OpenSourceNeuro/PoorLabs-Stimulator-V2/3D Renderings/Left.dxf

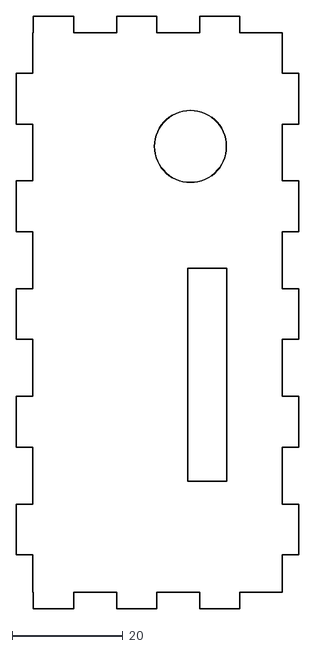
[picture p11: CAD file, 2023-07-23]
3D Renderings/Left.dxf
51.0 x 107.0
