OpenSourceNeuro/PoorLabs-Stimulator-V2/3D Renderings/Front.dxf

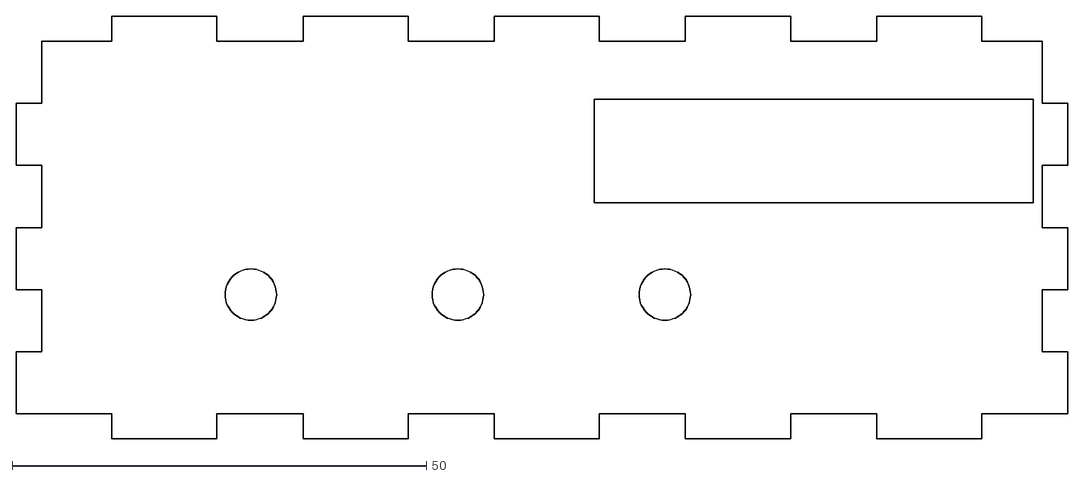
[picture p12: CAD file, 2023-07-23]
3D Renderings/Front.dxf
127.0 x 51.0
