OpenSourceNeuro/PoorLabs-Stimulator-V2/3D Renderings/Top.dxf

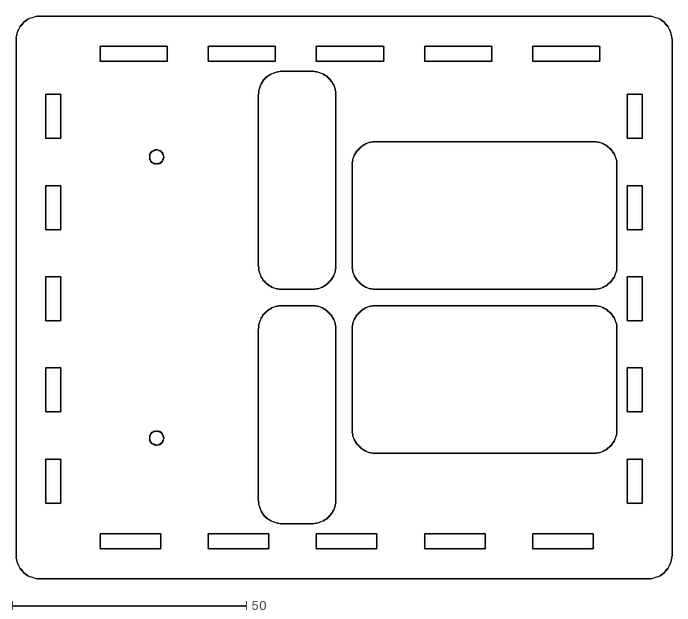
[picture p13: CAD file, 2023-07-23]
3D Renderings/Top.dxf
140.0 x 120.0
