OpenSourceNeuro/PoorLabs-Stimulator-V2/3D Renderings/Back.dxf

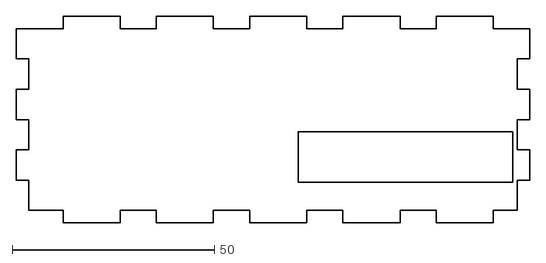
[picture p14: CAD file, 2023-07-23]
3D Renderings/Back.dxf
127.0 x 51.0
