OpenSourceNeuro/PoorLabs-Stimulator-V2/3D Renderings/Right.dxf

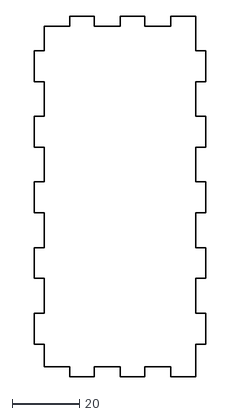
[picture p15: CAD file, 2023-07-23]
3D Renderings/Right.dxf
51.0 x 107.0
