OpenSourceNeuro/PoorLabs-Stimulator-V2/3D Renderings/Bottom.dxf

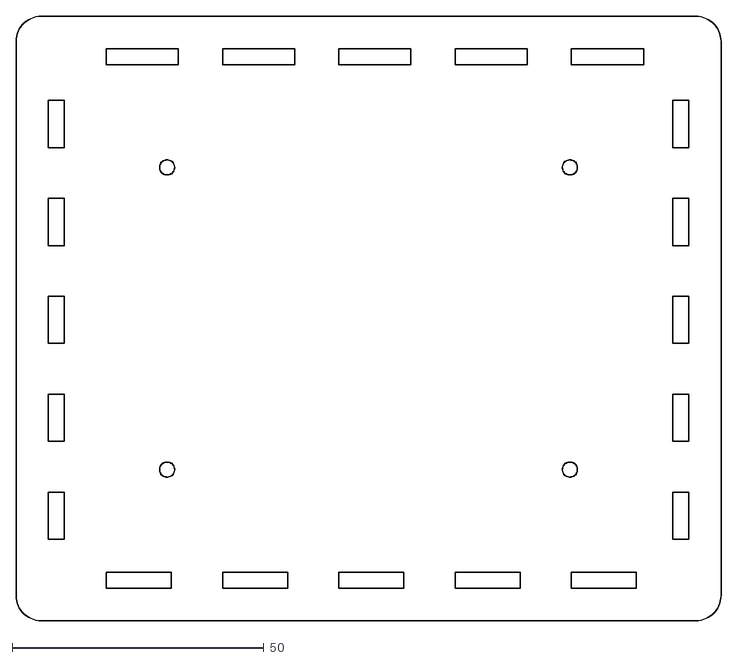
[picture p16: CAD file, 2023-07-23]
3D Renderings/Bottom.dxf
140.0 x 120.0
