OpenSourceNeuro/PoorLabs-Stimulator-V2/Documentation/Thorlabs Chrolis - Breakout Box/BBC1-AutoCADDXF.dxf

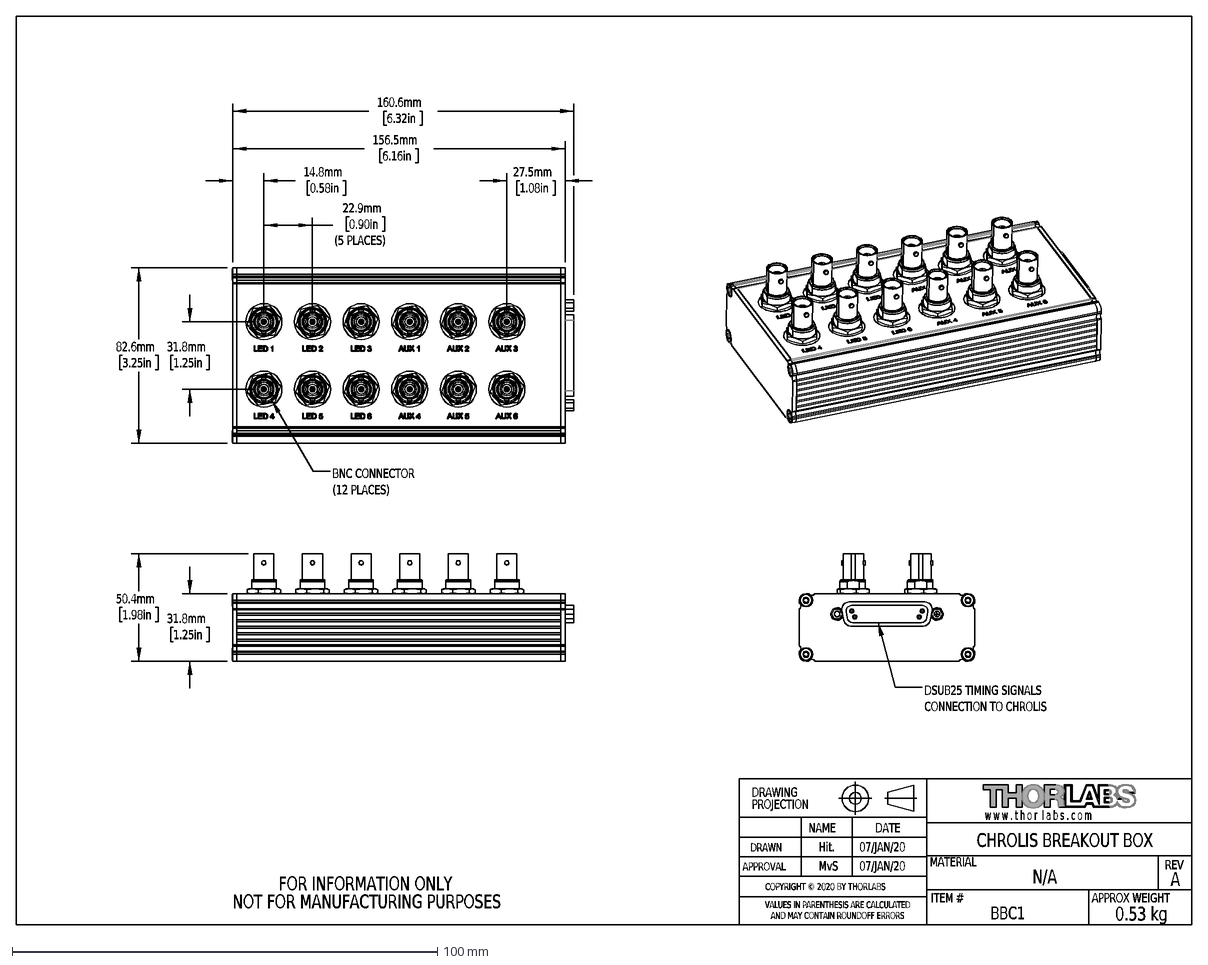
[picture p17: CAD file, 2023-07-23]
Documentation/Thorlabs Chrolis - Breakout Box/BBC1-AutoCADDXF.dxf
A
BBC1
MATERIAL
DRAWN
APPROVAL
REV
Hit.
MvS
07/JAN/20
DATE
w w w . t h o r l a b s . c o m
ITEM #
APPROX WEIGHT
N/A
0.53 kg
VALUES IN PARENTHESIS ARE CALCULATED
AND MAY CONTAIN ROUNDOFF ERRORS
DRAWING
PROJECTION
NAME
FOR INFORMATION ONLY
NOT FOR MANUFACTURING PURPOSES
CHROLIS BREAKOUT BOX
COPYRIGHT © 2020 BY THORLABS
160.6mm
6.32in
156.5mm
6.16in
14.8mm
0.58in
22.9mm
0.90in
(5 PLACES)
31.8mm
1.25in
82.6mm
3.25in
27.5mm
1.08in
BNC CONNECTOR
(12 PLACES)
50.4mm
1.98in
DSUB25 TIMING SIGNALS
CONNECTION TO CHROLIS
