OpenSourceNeuro/PoorLabs-Stimulator-V2/Documentation/Thorlabs Chrolis - Breakout Box/BBC1-Solidworks.sldprt

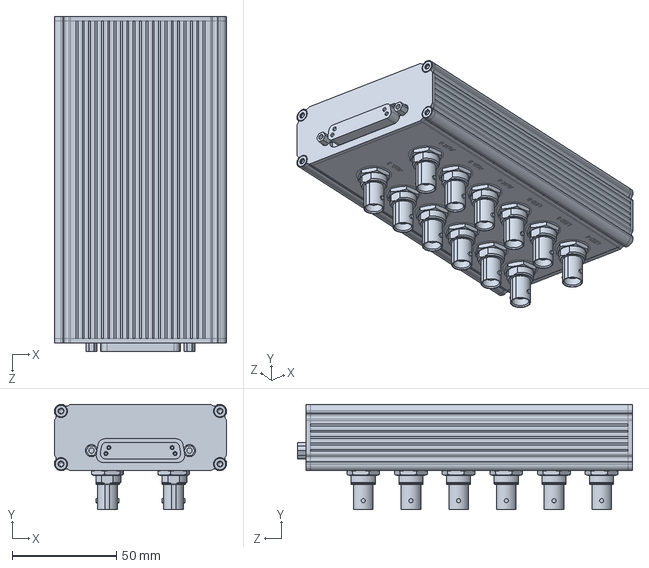
[picture p18: CAD file, 2023-07-23]
Documentation/Thorlabs Chrolis - Breakout Box/BBC1-Solidworks.sldprt
82.5 x 50.4 x 160.6 mm
