OpenSourceNeuro/PoorLabs-Stimulator-V2/Documentation/Thorlabs Chrolis - Breakout Box/BBC1-AutoCADPDF.pdf

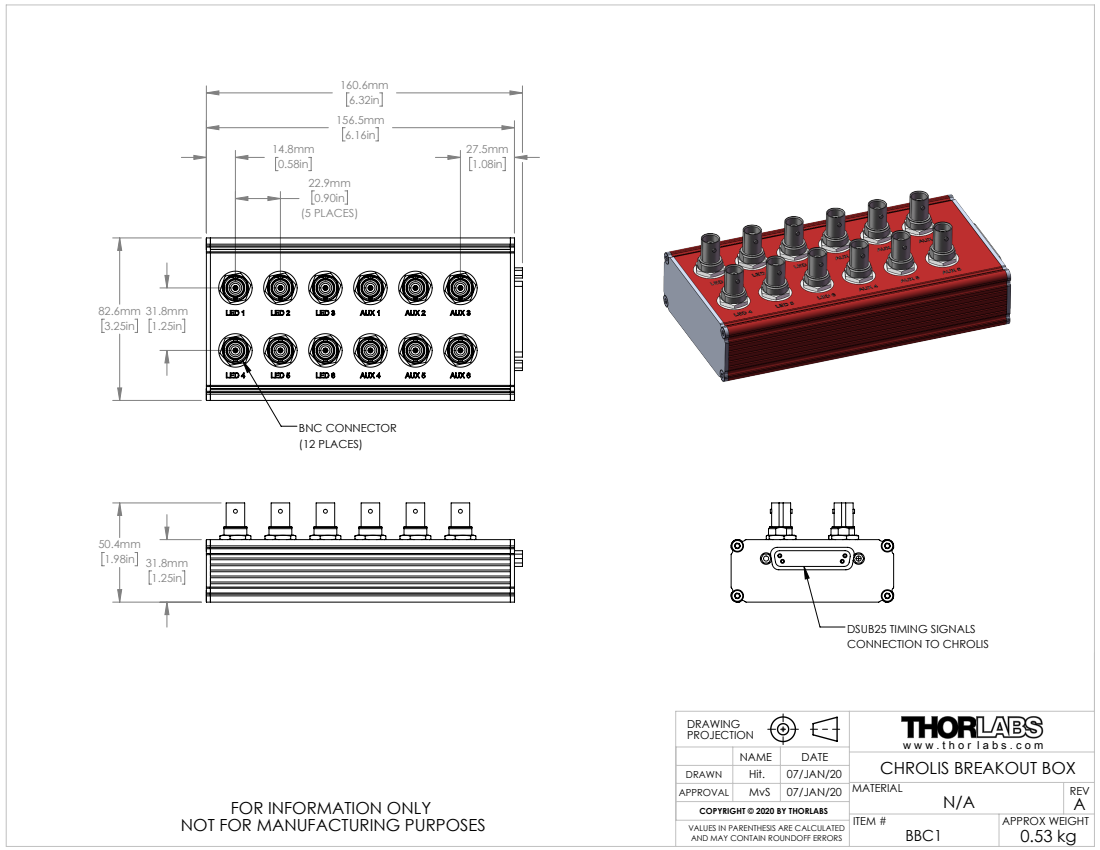
[picture p19: page 1]
(5 PLACES); BNC CONNECTOR (12 PLACES); ITEM #; APPROX WEIGHT

DSUB25 TIMING SIGNALS
CONNECTION TO CHROLIS

DRAWING PROJECTION | | w w w . t h o r l a b s . c o m

NAME | DATE
APPROVAL | MvS | 07/JAN/20 | MATERIAL N/A | REV A

CHROLIS BREAKOUT BOX

DRAWN | Hit. | 07/JAN/20

FOR INFORMATION ONLY
NOT FOR MANUFACTURING PURPOSES

COPYRIGHT © 2020 BY THORLABS
0.53 kg VALUES IN PARENTHESIS ARE CALCULATED
AND MAY CONTAIN ROUNDOFF ERRORS
