OpenSourceNeuro/PoorLabs-Stimulator-V2/PCB/Chrolis-LCR-Connector/Chrolis-LCR-Connector.kicad_pcb

## KiCad design PCB/Chrolis-LCR-Connector/Chrolis-LCR-Connector.kicad_pcb (2023-07-23)

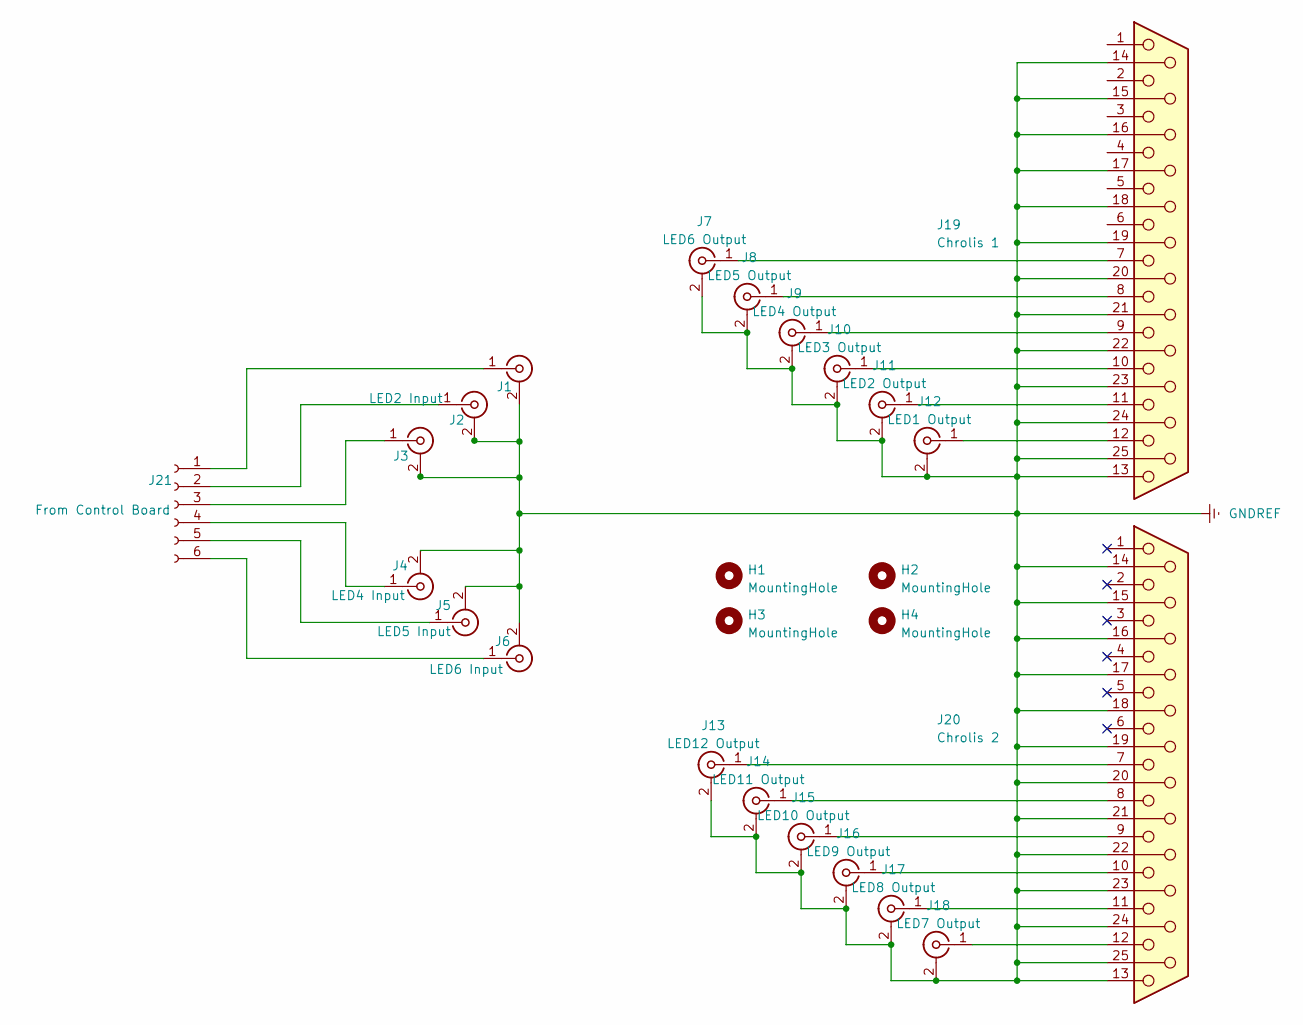
[picture p20: schematic Chrolis-LCR-Connector.kicad_sch]

Parts:
H1, H2, H3, H4: MountingHole; MountingHole_3mm
J1, J3: (no value)
J2: LED2 Input; SMA_Amphenol_132291_Vertical
J4: LED4 Input; SMA_Amphenol_132291_Vertical
J5: LED5 Input; SMA_Amphenol_132291_Vertical
J6: LED6 Input; SMA_Amphenol_132291_Vertical
J7: LED6 Output; SMA_Amphenol_132291_Vertical
J8: LED5 Output; SMA_Amphenol_132291_Vertical
J9: LED4 Output; SMA_Amphenol_132291_Vertical
J10: LED3 Output; SMA_Amphenol_132291_Vertical
J11: LED2 Output; SMA_Amphenol_132291_Vertical
J12: LED1 Output; SMA_Amphenol_132291_Vertical
J13: LED12 Output; SMA_Amphenol_132291_Vertical
J14: LED11 Output; SMA_Amphenol_132291_Vertical
J15: LED10 Output; SMA_Amphenol_132291_Vertical
J16: LED9 Output; SMA_Amphenol_132291_Vertical
J17: LED8 Output; SMA_Amphenol_132291_Vertical
J18: LED7 Output; SMA_Amphenol_132291_Vertical
J19: Chrolis 1; DSUB-25_Female_Horizontal_P2.77x2.84mm_EdgePinOffset9.90mm_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
J20: Chrolis 2; DSUB-25_Female_Horizontal_P2.77x2.84mm_EdgePinOffset9.90mm_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
J21: From Control Board; JST_XH_S6B-XH-A_1x06_P2.50mm_Horizontal

Connections:
GNDREF: J1.2 (Ext), J4.2 (Ext), J5.2 (Ext), J6.2 (Ext), J7.2 (Ext), J8.2 (Ext), J9.2 (Ext), J10.2 (Ext), J11.2 (Ext), J12.2 (Ext), J13.2 (Ext), J14.2 (Ext), J15.2 (Ext), J16.2 (Ext), J17.2 (Ext), J18.2 (Ext), J19.13, J19.14, J19.15, J19.16, J19.17, J19.18, J19.19, J19.20, J19.21, J19.22, J19.23, J19.24, J19.25, J20.13, J20.14, J20.15, J20.16, J20.17, J20.18, J20.19, J20.20, J20.21, J20.22, J20.23, J20.24, J20.25
unnamed: J1.1 (In), J21.1
unnamed: J2.1 (In), J21.2
unnamed: J10.1 (In), J19.10
unnamed: J11.1 (In), J19.11
unnamed: J12.1 (In), J19.12
unnamed: J13.1 (In), J20.7
unnamed: J14.1 (In), J20.8
unnamed: J15.1 (In), J20.9
unnamed: J16.1 (In), J20.10
unnamed: J17.1 (In), J20.11
unnamed: J18.1 (In), J20.12
unnamed: J7.1 (In), J19.7
unnamed: J8.1 (In), J19.8
unnamed: J9.1 (In), J19.9
unnamed: J3.1 (In), J21.3
unnamed: J4.1 (In), J21.4
unnamed: J5.1 (In), J21.5
unnamed: J6.1 (In), J21.6

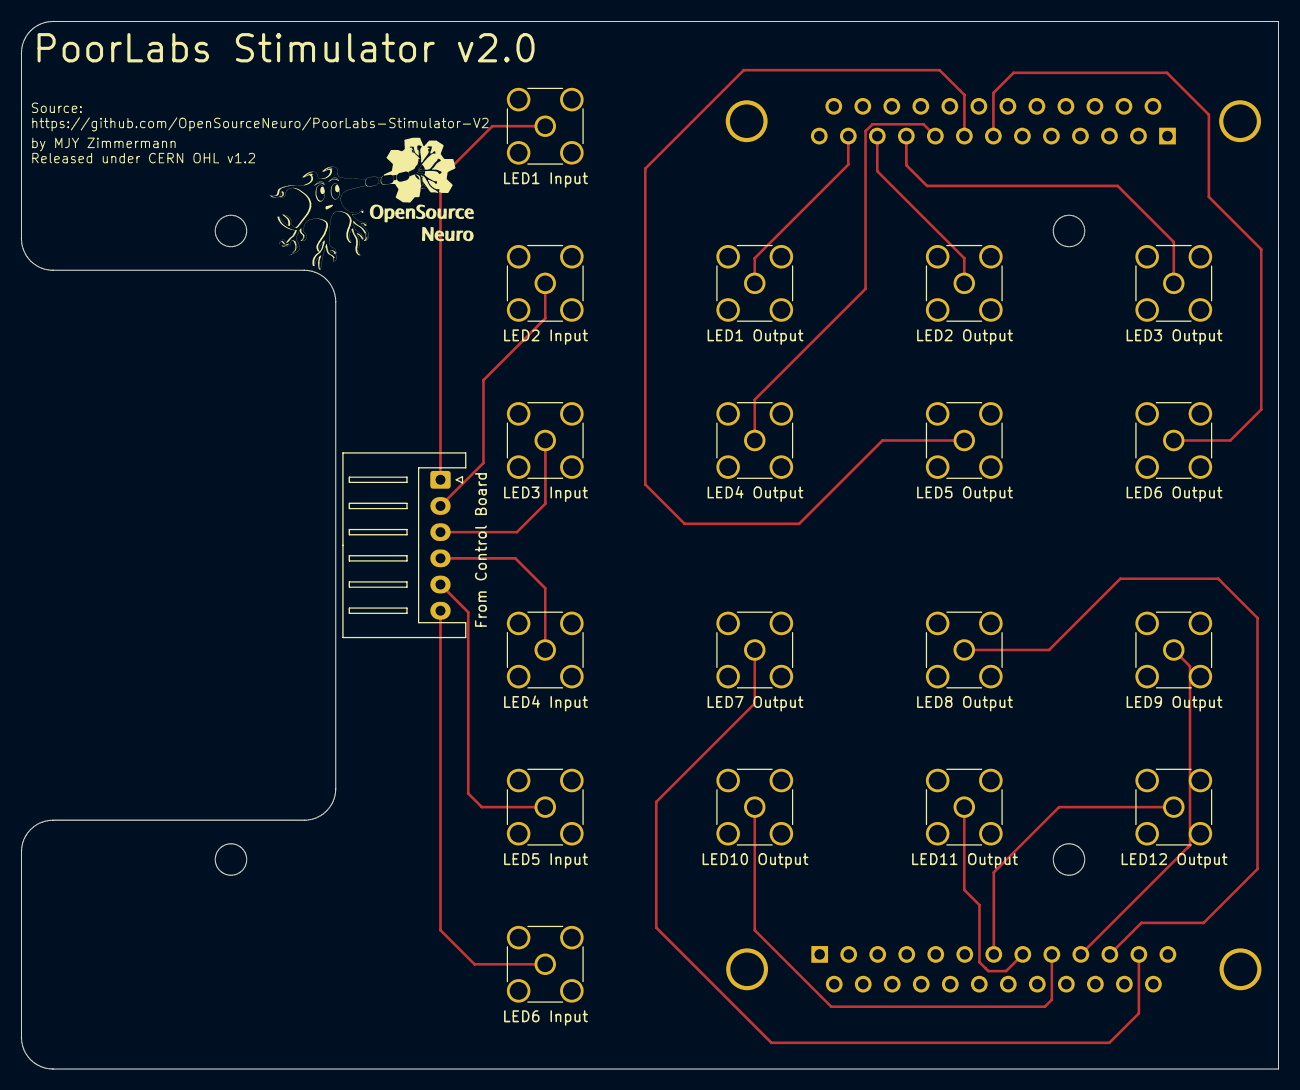
[picture p21: board Chrolis-LCR-Connector.kicad_pcb from above]

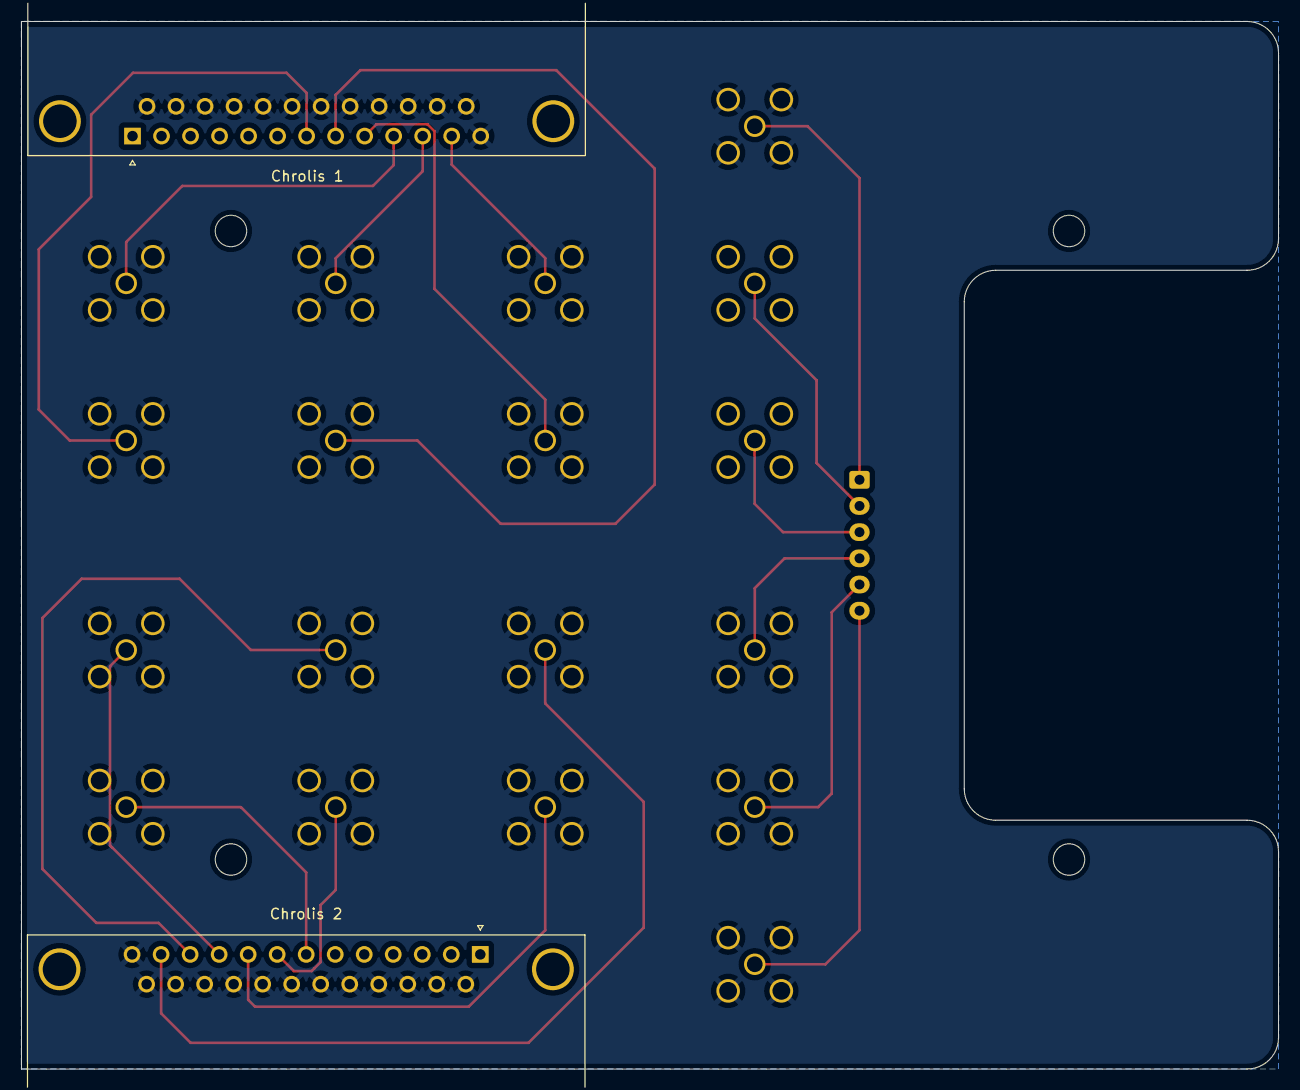
[picture p22: board Chrolis-LCR-Connector.kicad_pcb from below]

Board: 2 copper layers, 120.0 x 100.0 mm, 25 parts (2 on the bottom side), 19 nets.
