OpenSourceNeuro/PoorLabs-Stimulator-V2/PCB/PoorLab Stimulator/Chrolis-LCR.kicad_pcb

## KiCad design PCB/PoorLab Stimulator/Chrolis-LCR.kicad_pcb (2023-07-23)

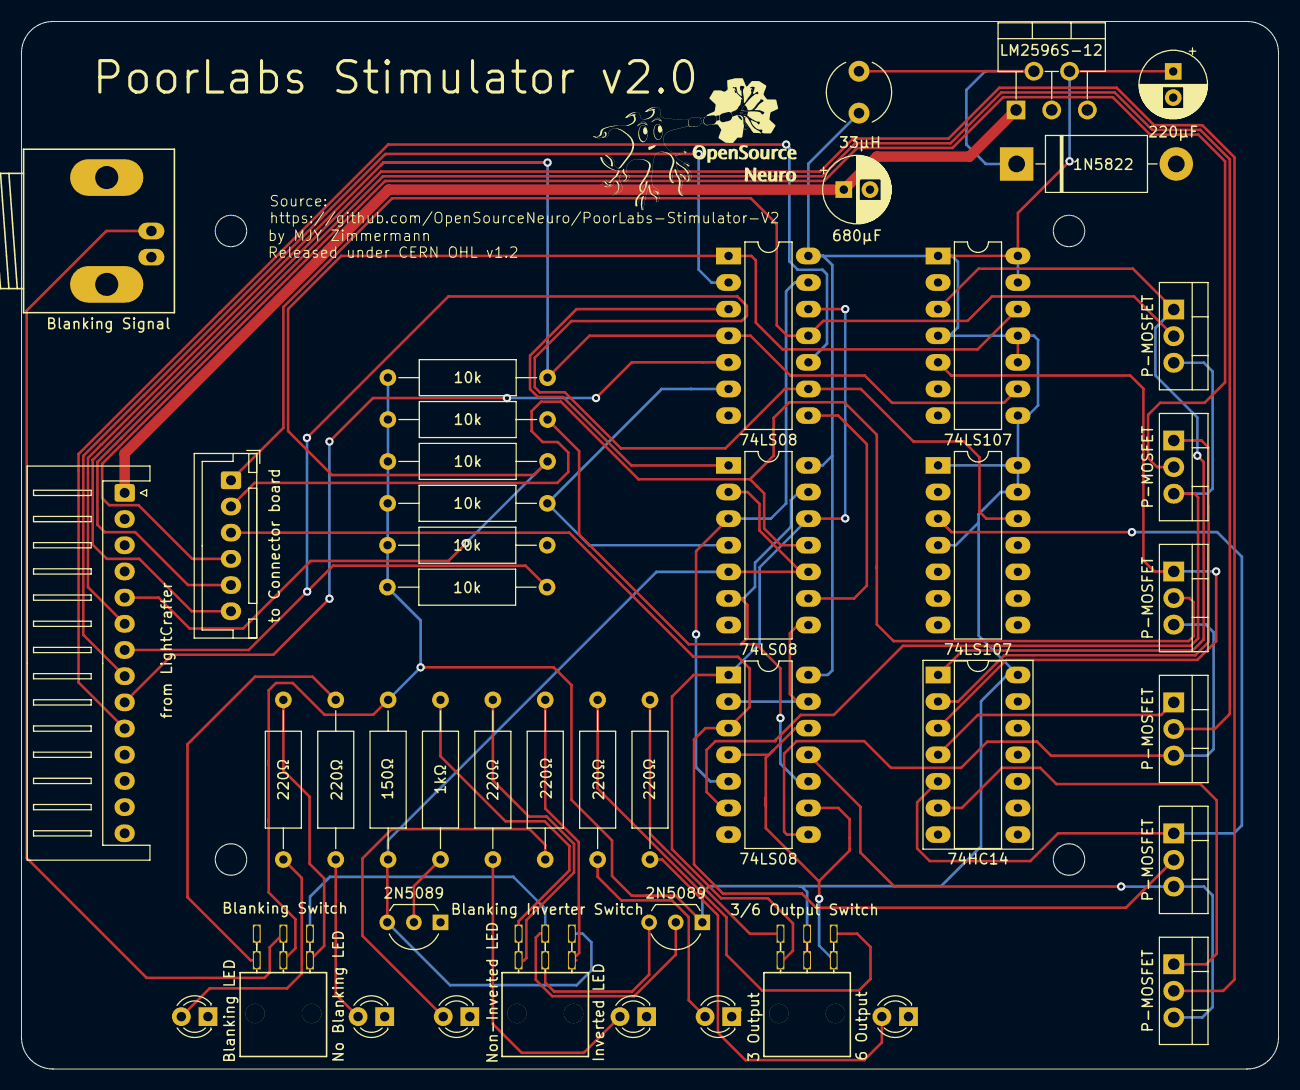
[picture p23: board Chrolis-LCR.kicad_pcb from above]

Board: 2 copper layers, 120.0 x 100.0 mm, 49 parts (0 on the bottom side), 51 nets.

Parts:
C1: 220μF; CP_Radial_D6.3mm_P2.50mm
C2: 680μF; CP_Radial_D6.3mm_P2.50mm
D1: Blanking LED; LED_D3.0mm
D2: No Blanking LED; LED_D3.0mm
D3: Inverted LED; LED_D3.0mm
D4: Non-Inverted LED; LED_D3.0mm
D5: 3 Output; LED_D3.0mm
D6: 6 Output; LED_D3.0mm
D7: 1N5822; D_DO-201AD_P15.24mm_Horizontal
H1, H2, H3, H4: MountingHole; MountingHole_3mm
J1: Blanking Signal; BNC_Socket_TYCO-AMP_LargePads
J2: from LightCrafter; JST_XH_S14B-XH-A_1x14_P2.50mm_Horizontal
J3: to Connector board; JST_XH_B6B-XH-A_1x06_P2.50mm_Vertical
L1: 33μH; L_Radial_D6.0mm_P4.00mm
Q0, Q1: 2N5089; TO-92L_Inline_Wide
Q2, Q3, Q4, Q5, Q6, Q7: P-MOSFET; TO-220-3_Vertical
R1, R2, R5, R6, R7, R8: 220Ω; R_Axial_DIN0309_L9.0mm_D3.2mm_P15.24mm_Horizontal
R3: 150Ω; R_Axial_DIN0309_L9.0mm_D3.2mm_P15.24mm_Horizontal
R4: 1kΩ; R_Axial_DIN0309_L9.0mm_D3.2mm_P15.24mm_Horizontal
R9, R10, R12, R13, R15, R16: 10k; R_Axial_DIN0309_L9.0mm_D3.2mm_P15.24mm_Horizontal
SW1: Blanking Switch; maxi_DPDT_Angled
SW2: Blanking Inverter Switch; maxi_DPDT_Angled
SW3: 3/6 Output Switch; maxi_DPDT_Angled
U0: LM2596S-12; TO-220-5_P3.4x3.7mm_StaggerOdd_Lead3.8mm_Vertical
U1, U2, U3: 74LS08; DIP-14_W7.62mm_LongPads
U4: 74HC14; DIP-14_W7.62mm_Socket_LongPads
U5, U6: 74LS107; DIP-14_W7.62mm_LongPads

Connections:
3LED switch: SW3.4 (A), U1.12, U2.12, U3.1
5V: C1.1, L1.2, Q0.1 (E), R3.2, R9.1, R10.2, R12.1, R13.1, R15.1, R16.1, SW1.5 (B), SW3.2 (B), SW3.5 (B), U0.4 (FB), U1.14 (VCC), U2.14 (VCC), U3.14 (VCC), U4.14 (VCC), U5.1 (J), U5.4 (K), U5.8 (J), U5.10 (~R), U5.11 (K), U5.13 (~R), U5.14 (VCC), U6.1 (J), U6.4 (K), U6.13 (~R), U6.14 (VCC)
6LED switch: SW3.6 (C), U3.4, U3.9, U3.12
6LED/LED1 Input: Q2.3 (S), Q3.3 (S), U3.6
6LED/LED2 Input: Q4.3 (S), Q5.3 (S), U3.8
6LED/LED3 Input: Q6.3 (S), Q7.3 (S), U3.11
12V: C2.1, J2.1, U0.1 (VIN)
Blanking: Q1.3 (C), R3.1, SW2.3 (C), U2.2, U2.5, U2.10
GNDREF: C1.2, C2.2, D1.1 (K), D2.1 (K), D3.1 (K), D4.1 (K), D5.1 (K), D6.1 (K), D7.2 (A), J1.2 (Ext), J2.12, J2.13, J2.14, Q1.1 (E), U0.3 (GND), U0.5 (~ON/OFF), U1.7 (GND), U2.7 (GND), U3.7 (GND), U4.7 (GND), U5.7 (GND), U6.7 (GND)
LED1 Input: J3.1, Q2.2 (D), U1.11
LED1 PWM: J2.8, U1.2
LED1 blanked: U1.13, U2.3, U3.5
LED1 enable: J2.5, R9.2, U1.1, U5.12 (C)
LED2 Input: J3.2, Q4.2 (D), U2.11
LED2 PWM: J2.9, U1.5
LED2 blanked: U2.6, U2.13, U3.10
LED2 enable: J2.6, R12.2, U1.4, U5.9 (C)
LED3 Input: J3.3, Q6.2 (D), U3.3
LED3 PWM: J2.10, U1.10
LED3 blanked: U2.8, U3.2, U3.13
LED3 enable: J2.7, R15.2, U1.9, U6.12 (C)
LED4 Input: J3.4, Q3.2 (D)
LED5 Input: J3.5, Q5.2 (D)
LED6 Input: J3.6, Q7.2 (D)
Latch LED1: Q2.1 (G), U4.1, U5.3 (Q)
Latch LED2: Q4.1 (G), U4.3, U5.5 (Q)
Latch LED3: Q6.1 (G), U4.5, U6.3 (Q)
unnamed: D1.2 (A), R1.1
unnamed: D2.2 (A), R2.1
unnamed: D3.2 (A), R5.1
unnamed: D4.2 (A), R6.1
unnamed: D5.2 (A), R7.1
unnamed: D6.2 (A), R8.1
unnamed: D7.1 (K), L1.1, U0.2 (OUT)
unnamed: J1.1 (In), SW1.2 (B)
unnamed: Q0.2 (B), SW1.3 (C), SW2.2 (B)
unnamed: Q0.3 (C), SW2.5 (B)
unnamed: Q1.2 (B), R4.1
unnamed: Q3.1 (G), U4.2
unnamed: Q5.1 (G), U4.4
unnamed: Q7.1 (G), U4.6
unnamed: R1.2, SW1.6 (C)
unnamed: R2.2, SW1.4 (A)
unnamed: R4.2, SW2.1 (A)
unnamed: R5.2, SW2.4 (A)
unnamed: R6.2, SW2.6 (C)
unnamed: R7.2, SW3.3 (C)
unnamed: R8.2, SW3.1 (A)
unnamed: U1.3, U2.1
unnamed: R10.1, U1.6, U2.4
unnamed: U1.8, U2.9
