OpenSourceNeuro/PoorLabs-Stimulator-V2/(commit log)

2023-07-23 First Commit 3D
    [Back.dxf, Bottom.dxf, Front.dxf, Left.dxf, PoorLabs Stimulator.scad, Right.dxf, Top.dxf]
2023-07-23 First commit Documentation
    [BBC1-AutoCADDXF.dxf, BBC1-Solidworks.sldprt]
2023-07-23 First commit PCB
    [Chrolis-LCR-B_Cu.gbr, Chrolis-LCR-B_Mask.gbr, Chrolis-LCR-B_Paste.gbr, Chrolis-LCR-B_Silkscreen.gbr, Chrolis-LCR-Connector-B_Cu.gbr, Chrolis-LCR-Connector-B_Mask.gbr, Chrolis-LCR-Connector-B_Paste.gbr, Chrolis-LCR-Connector-B_Silkscreen.gbr]
