OpenSourceNeuro/PoorLabs-Stimulator-V2/(notices)

Notices in the files:
PCB/PoorLab Stimulator/Chrolis-LCR.kicad_pcb:
Released under CERN OHL v1.2
